mkrawiec261/RemoteCarSTM32/docs/Raport.pdf

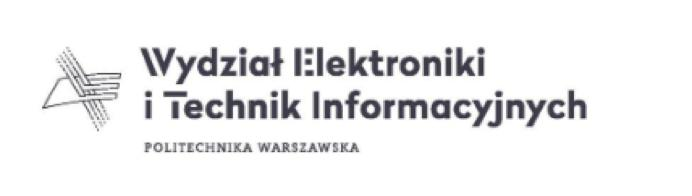
[picture p1: figure]

## 28 stycznia 2025

# Sprawozdanie PMiK

## Zdalnie sterowany samochodzik

Marcin Krawiec 325027
Tymoteusz Krasnowski 325026

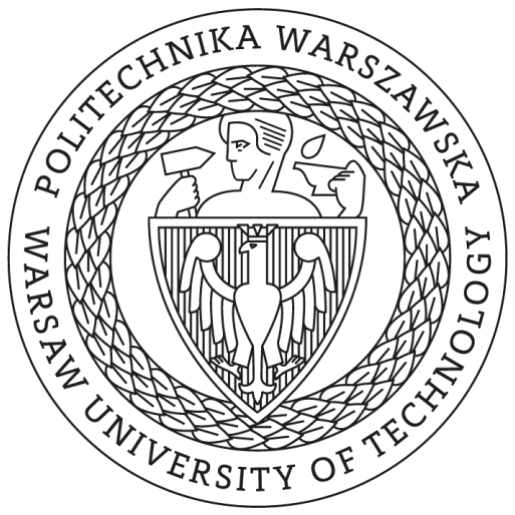
[picture p2: figure]

## Spis treści

## 1.Wstęp

## 1.1. Temat projektu

Tematem projektu jest zbudowanie od podstaw zdalnie sterowanego samochodu z napędem na cztery koła, z wykorzystaniem mikrokontrolera STM32 Nucleo. Sterowanie pojazdem będzie odbywać się bezprzewodowo, za pomocą joysticka komunikującego się z pojazdem przez moduły Wi-Fi oparte na ESP8266. Pojazd będzie zasilany napięciem ok. 6 V z połączonych ze sobą szeregowo baterii. Napęd składa się z 4 silników DC, sterowanych parami z drivera PWM. Dodatkowo, pojazd będzie posiadał czujnik odległości, który będzie ostrzegał użytkownika przed zbyt małą odległością od przeszkody za pomocą zapalenia czerwonej diody LED.

## 1.2. Wykaz realizowanych funkcji

1. Zastosowanie mikrokontrolerów STM32 Nucleo F303RE:
- Wykorzystanie dwóch STM32 jako jednostek centralnych sterujących pracą silników, odczytem danych z joysticka, komunikacją przez Wi-Fi oraz dodatkowymi czujnikami i peryferiami
2. Sterowanie napędem pojazdu:
- Regulacja pracy silników, za pomocą zewnętrznego drivera DRV8835,
- Regulacja prędkości za pomocą sygnału PWM generowanego przez mikrokontroler STM32
- Wybór kierunku obrotu silników za pomocą odpowiedniego stanu logicznego 2 portów GPIO
3. Sterowanie pojazdem za pomocą joysticka:
- Odczyt wychylenia gałki joysticka za pomocą napięć generowanych z dwóch potencjometrów oraz przetworzenie ich na wartość cyfrową za pomocą przetwornika ADC
- Komunikacja bezprzewodowa przez Wi-Fi
4. Obsługa czujnika odległości:
- Czujnik odległości odczytuje dystans od przeszkody i generuje przerwanie w momencie, gdy odległość jest mniejsza niż 30 cm. W obsłudze przerwania mikrokontroler zaświeca czerwoną diodę LED

## 1.3. Ogólny opis algorytmu

1. Inicjalizacja:
a. Konfigurowanie wszystkich wymaganych komponentów i urządzeń w tym pinów dla drivera silnika, modułów ESP8266, czujnika odległości i diod LED
b. Inicjalizacja liczników generujących sygnał PWM
c. Inicjalizacja modułów komunikacyjnych Wi-Fi do odbioru danych z joysticka
2. Obiór sygnałów z joysticka:
a. Odbiór informacji o wartości wychylenia joysticka w kierunku x i y
b. Przetworzenie danych przez ADC na wartości cyfrowe
3. Przekazywanie sygnałów poprzez Wi-Fi
a. Przesyłanie informacji o pozycji joysticka w osi x i y poprzez interfejs komunikacyjny UART do modułu ESP8266
b. Przesłanie danych między modułami ESP8266 i przekazanie ich do drugiego mikrokontrolera STM32 za pomocą UART
4. Sterowanie pracą silników:
a. STM32 odczytuje nadesłane dane i za pomocą algorytmu generuje 2 sygnały PWM o odpowiednim wypełnieniu, sterujące pracą silników. W tym momencie również wysterowuje linie GPIO w odpowiedni stan logiczny
5. Monitorowanie odległości od przeszkód:
a. Odczyt danych z czujnika odległości w pętli z wykorzystaniem timera
b. Jeżeli odległość jest mniejsza niż progowa, zapala się dioda LED ostrzegająca o możliwej kolizji
6. Aktualizacja stanu pojazdu:
a. System odbiera dane z joysticka i na bieżąco dostosowuje sygnał PWM do sterowania kierunkiem i prędkością

## 1.4. Wykaz użytych elementów

1. Zestaw ewaluacyjny STM32 Nucleo F303RE - 2x
2. Zestaw ewaluacyjny ESP32-WROOM-32
3. Moduł Wi-Fi ESP8266
4. Silnik szczotkowy DC FC-130SA - 4x
5. Driver DRV-8835 - 2x
6. Powerbank Xiaomi Redmi 10000 mAh
7. Baterie AAA - 6x
8. Koszyk na baterie AAA - 2x

## 2.Prace projektowe

## 2.1. Schemat blokowy

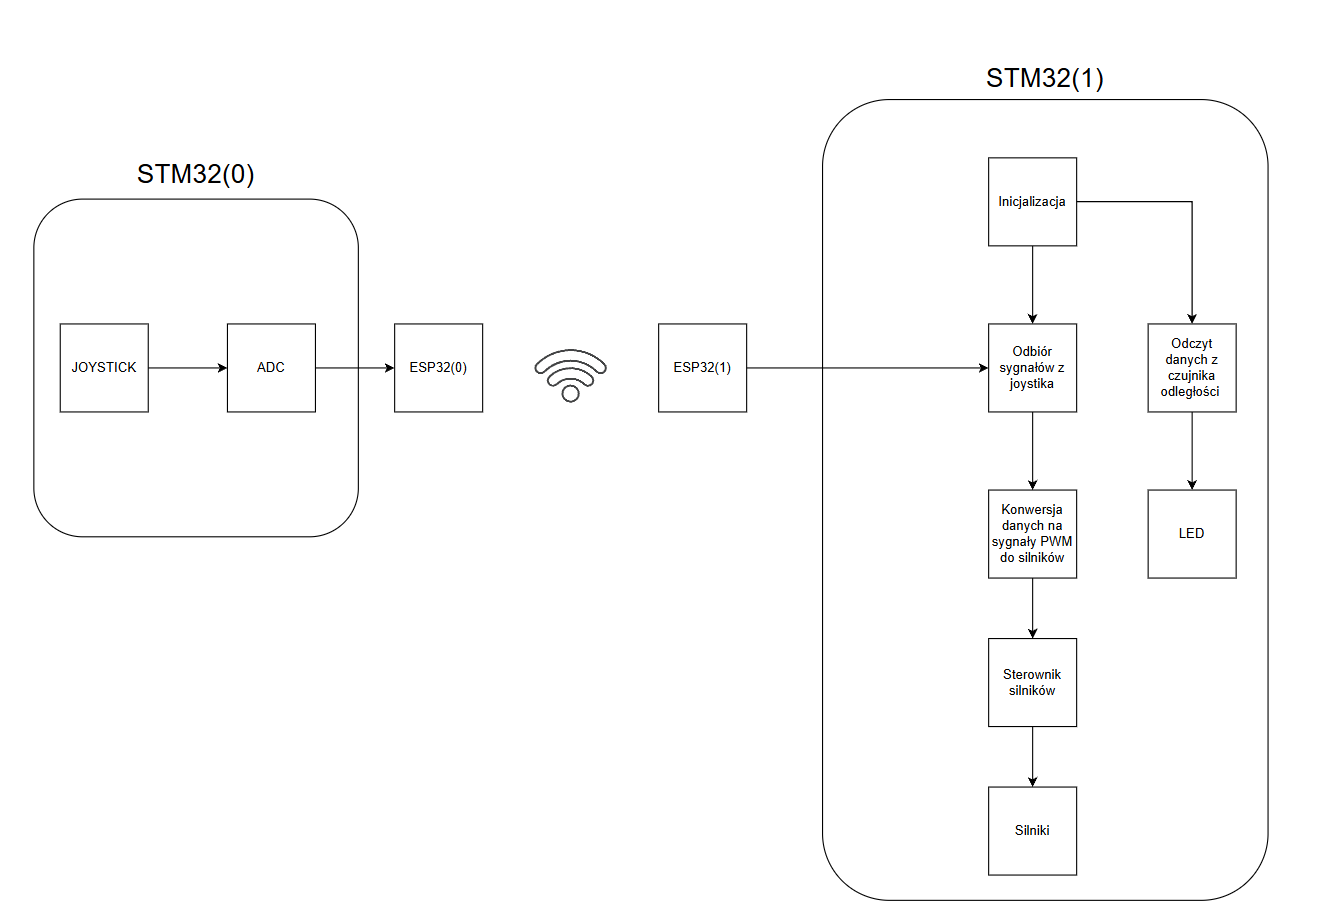
[picture p3: figure]

Rys 1. Schemat blokowy przedstawiający działanie samochodu i kontrolera

## 2.2. Schemat elektryczny

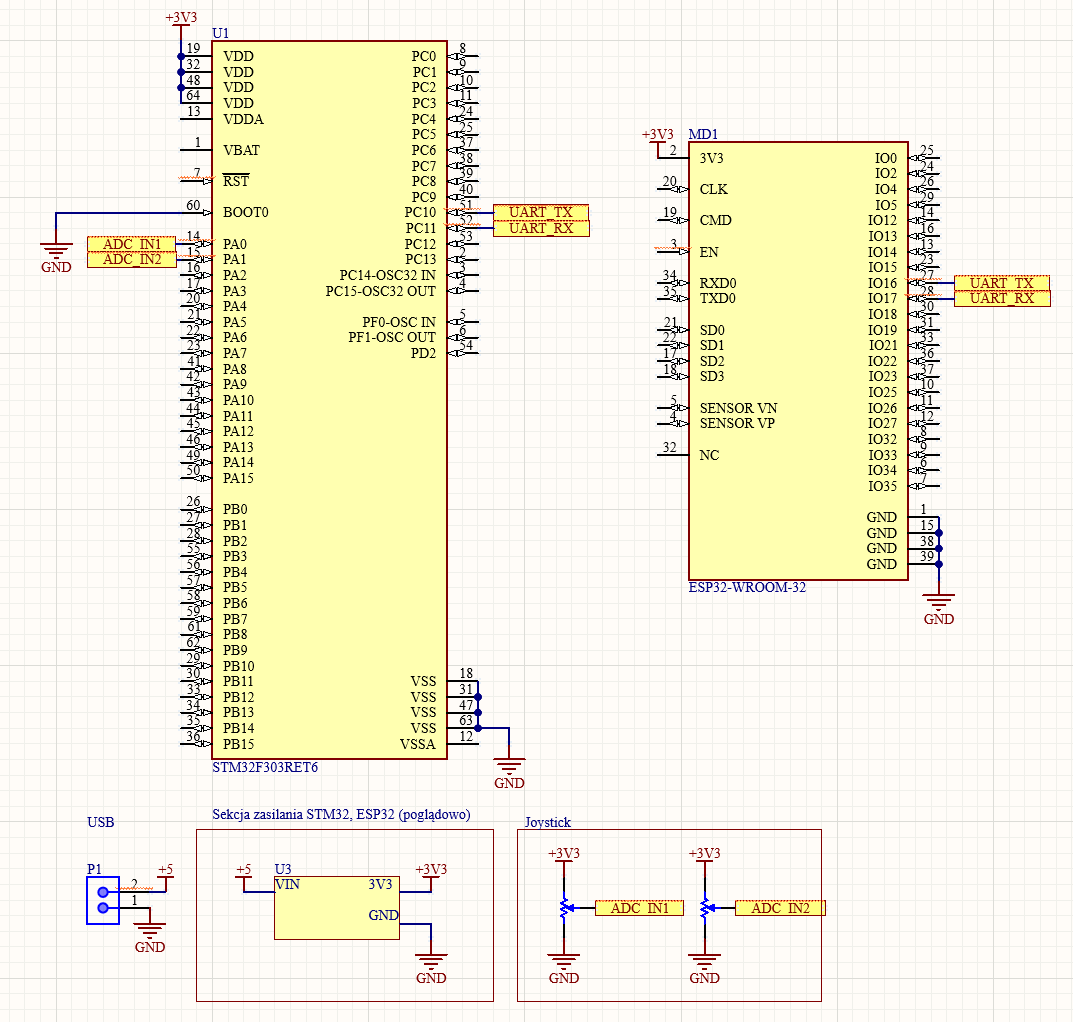
[picture p4: figure]

Rys 2. Schemat elektryczny kontrolera
Z racji na pusty (bez wyprowadzeń) prostokąt w Altium Designer zestawów ewaluacyjnych, na schemacie umieszczone są MCU. Pominięto w nich połączenia takie jak: debugger, diody, przyciski, kwarce itd. Natomiast dla przejrzystości zasilania układu, gdyż nie odbywa się przez port USB debuggera, widoczny jest blok sekcji zasilania (poglądowy).
Zasilanie kontrolera odbywa się przez USB-C z powerbanka. W Nucleo F303RE za zasilanie MCU odpowiada zworka w wyprowadzeniu J5, która wpinana jest na 2 sposoby: zasilanie z USB przez debugger oraz zewnętrznie. Dla naszych potrzeb zasilamy zewnętrznie. ESP32 nie posiada zworek, zasilanie odbywa się bezpośrednio wpinając się do pinu stabilizatora.

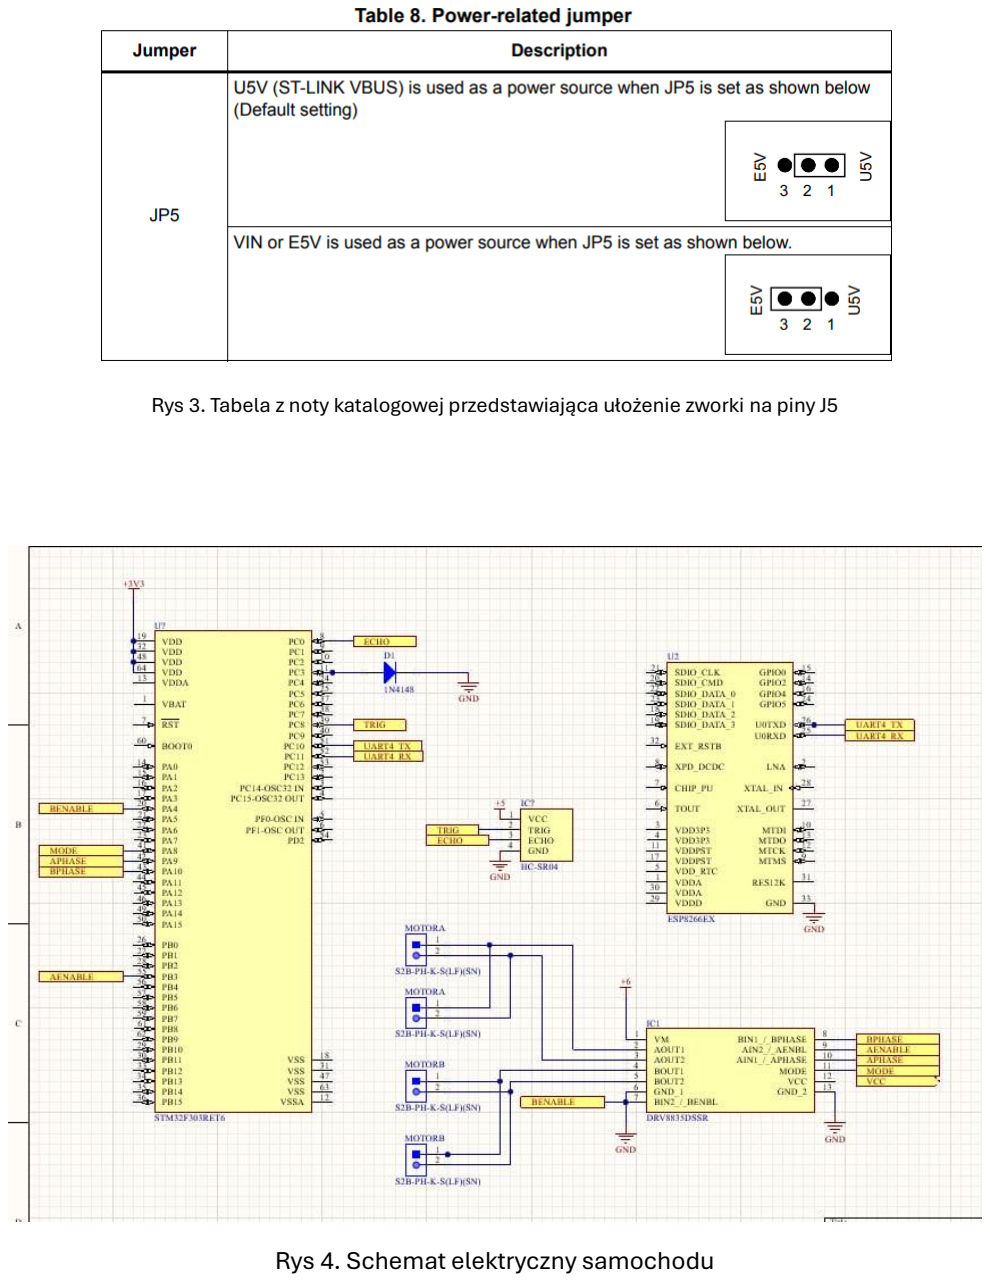
[picture p5: page 7]

Rys 3. Tabela z noty katalogowej przedstawiająca ułożenie zworki na piny J5

Rys 4. Schemat elektryczny samochodu

## 2.3. Komunikacja

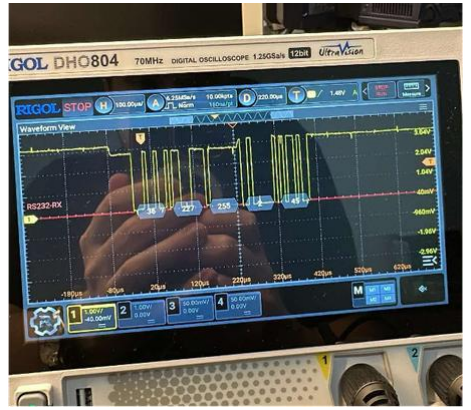
[picture p6: figure]

Rys 5. Podgląd komunikacji na oscyloskopie. Komunikacja odbywa się za pomocą interfejsu UART i protokołu ESP-NOW między ESP32. STM32 po stronie kontrolera wysyła 5 bajtów: ramka i 4 wartości z ADC, odpowiednio: starszy i młodszy bajt wychylenia X joysticka oraz starszy i młodszy bajt wychylenia Y joysticka.

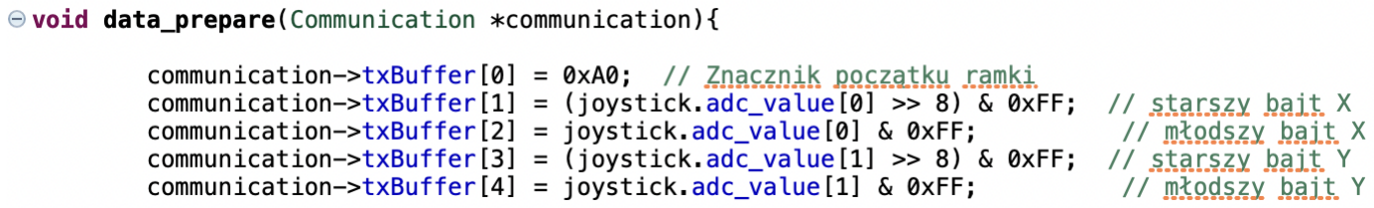
[picture p7: figure]

Rys 6. Bufor danych do wysłania, z ramką i rozdzieleniem wartości 16 bitowych na dwie 8-bitowe. Następnie dane są wysyłane do ESP32 z prędkością 115200 b/s przez DMA. Tam następuje ich odbiór i wysyłka za pomocą protokołu ESP-NOW, o ile zostanie znaleziony adres MAC odbiorcy.

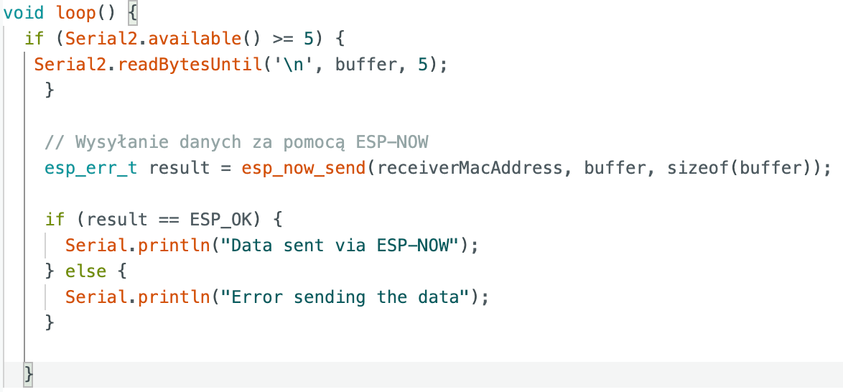
[picture p8: figure]

Rys 7. Pętla główna ESP32, w której dane są odczytywane z UART (Serial2) i wysyłane (esp_now_send).
Protokół ESP-NOW odbiera dane tylko w przerwaniu, zatem za każdym razem, gdy przyjdą nowe dane, wywołuje się przerwanie, w którym dane są kopiowane i wysyłane za pomocą UART do drugiej STM32.

Rys 8. Callback do odbioru danych, pętla while jest pusta.
Warto tutaj zaznaczyć, że domyślnie ESP32 jak i moduł ESP8266 sygnalizują status komunikacji niebieską diodą, dzięki czemu, gdy wystąpi jakiś problem można od razu wiedzieć, czy komunikacja przebiega prawidłowo – ułatwiony debugging. Następnie, dane muszą zostać z powrotem przekonwertowane na swoje 16-bitowe wartości. Służy do tego funkcja convertwifitada.

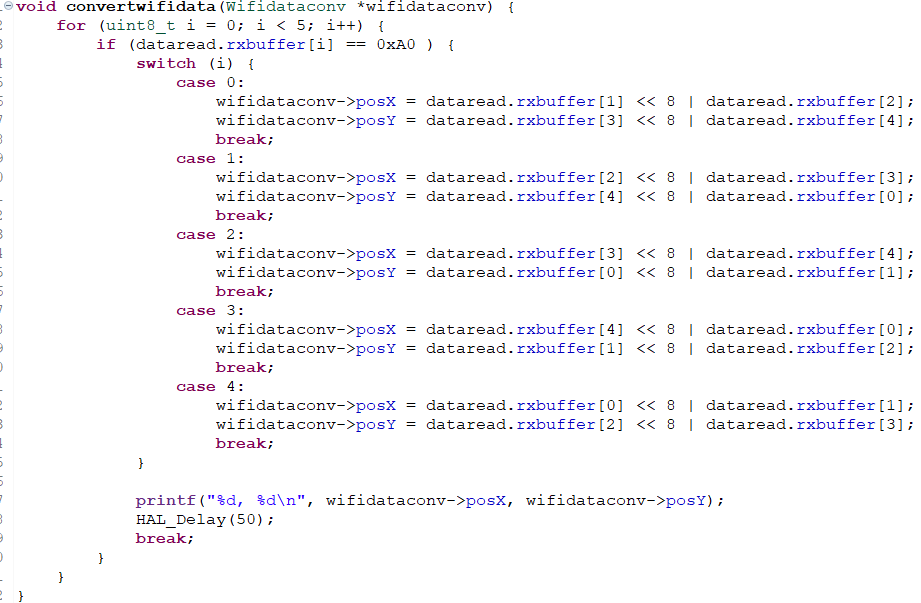
[picture p9: figure]

Rys 9. Funkcja convertwifidata
Ta funkcja nie tylko konwertuje 2 8-bitowe wartości na jedną 16-bitową, ale też wyszukuje ramki, czyli początku transmisji. Po odbiorze danych przez ESP8266 okazało się, że ramki nie przychodzą po kolei – są przesunięte w czasie. Musiał powstać mechanizm, który zapewni poprawny odczyt danych.
Jednak to nie koniec. Wartości z ADC potrafią być zaszumione, za sprawą beznadziejnej jakości joysticka z zestawu ewaluacyjnego arduino (klon, chińczyk), a podczas transmisji po Wi-Fi danych również może dość do uszkodzenia jej zawartości. W związku z tym, po odbiorze danych i konwersji ich do docelowych wartości, powstał filtr medianowy. Dzięki temu prostemu rozwiązaniu problem zniknął, a sama transmisja i jej dekodowanie pozostało niezmienione (mam tu na myśli bardziej zaawansowany mechanizm, na przykład z sumą kontrolną).

## 2.4. ADC

Joystick to nic innego jak dwa potencjometry, których rezystancję reguluje się odchyleniem gałki analogowej. Zatem obsługa joysticka wymaga użycia przetwornika analogowo-cyfrowego. Próbkuje on wartości z dwóch kanałów – X i Y gałki analogowej, o rozdzielczości 12 bitów i wysyła bezpośrednio do DMA.
ADC odczytuje wartości odchylenia joysticka z prędkością 61.5 cykli.

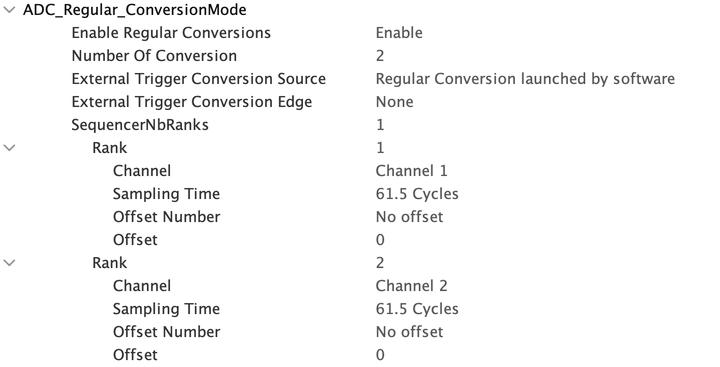
[picture p10: figure]

Rys 10. Fragment konfiguracji ADC z IOC.
2.4.1 Obsługa joysticka – plik konfiguracyjny i wykonawczy:

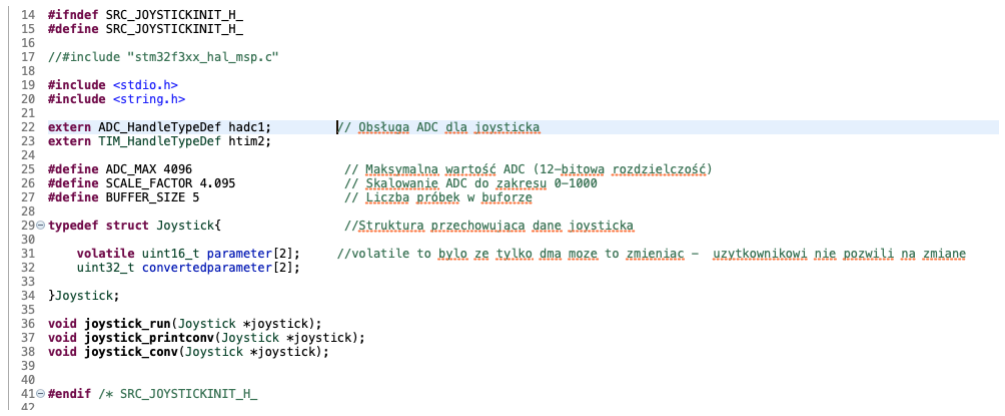
[picture p11: figure]

Rys 11. Plik konfiguracyjny joystickinit.h Plik joystickinit.h jest stworzoną przez nas biblioteką obsługi joysticka. Znajdują się w niej definicje przetwornika, odpowiednie stałe pozwalające na konwersje danych przekazywanych z ADC na takie bardziej przystępne dla naszych wymagań. Następnie plik zawiera strukturę danych, ze zmiennymi w postaci tablicy, do której przypisywane są aktualne wartości wychylenia joysticka. Plik zakończony jest deklaracjami funkcji wykorzystywanych w pliku implementacyjnym.

Rys 12. Plik implementacyjny joystickstart.c – funkcja obsługi ADC z DMA Funkcja joystick_run zawiera fragment inicjalizacji ADC oraz jego kalibracji, wraz z ze startem DMA. Pozwala na rozpoczęcie odczytywania danych z joysticka i zapisywanie ich w tablicy parameter[]. Następnie te dane zostają wysłane do drugiego STM32 zgodnie z procedurą opisaną powyżej.

## 2.5. Odczyt danych i filtracja:

Wysyłanie danych poprzez Wi-Fi ma tą niewygodną cechę, że wartości są dość podatne na szumy występujące w przestrzeni. W naszym projekcie sam fakt, że moduł ESP odbierający dane był bardzo blisko silników prądu stałego, które mogą powodować zakłamania odbieranych wartości. Problem występuje co kilka, kilkanaście próbek dlatego podjęliśmy działania mające na celu eliminację tego problemu.

Pierwszym z nich było zastosowanie filtru medianowego:

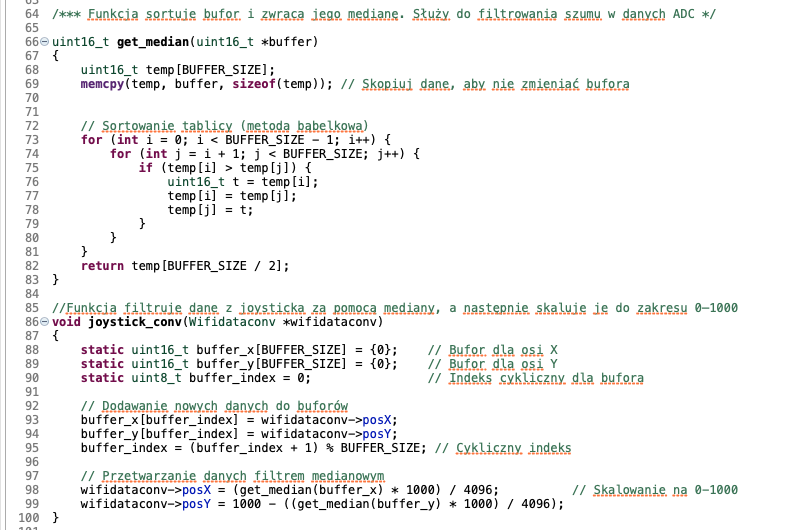
[picture p12: figure]

Rys 13. Plik wifidataconvert.c – funkcja filtrująca dane i skalująca do odpowiednich wartości

Pierwsza funkcja, get_median, jest odpowiedzialna za filtrowanie danych. Implementuje metodę mediany, polegającą na posortowaniu kopii tablicy danych i wybraniu wartości środkowej. Dane są kopiowane do tymczasowej tablicy temp, aby nie zmieniać oryginalnych wartości. Następnie funkcja stosuje algorytm sortowania bąbelkowego, który porównuje i zamienia miejscami elementy, aż cała tablica zostanie uporządkowana. Po zakończeniu zwracana jest mediana wartości. Mediana jest używana, ponieważ skutecznie eliminuje wpływ pojedynczych, znacząco odchylonych wartości (szumów) na dane wejściowe.

Druga funkcja, joystick_conv, wykorzystuje funkcję get_median do przetwarzania danych z joysticka. Dane te są reprezentowane przez współrzędne osi X i Y, które są
odczytywane z obiektu Wifidataconv. Funkcja przechowuje ostatnie wartości z joysticka w dwóch oddzielnych buforach, jednym dla osi X i jednym dla osi Y. Bufory te mają ustaloną wielkość (zdefiniowaną przez BUFFER_SIZE), a nowe wartości są dodawane w sposób cykliczny, nadpisując najstarsze dane.
Dla każdej nowej wartości dane w buforze są przetwarzane za pomocą
funkcji get_median, co pozwala na odfiltrowanie szumów. Po zastosowaniu mediany wartości są skalowane do zakresu 0–1000.
Drugą metodą, którą szerzej opiszę w pętli głównej jest zastosowanie ogranicznika wartości. W momencie, gdy po skalowaniu wartości, wychylenia joysticka są większe niż 1000 (czyli większe niż maksymalne wypełnienie PWM) to wykorzystywana jest funkcja ograniczająca ten zakres do wartości maksymalnej – 1000.
Wszystkie stałe opisane są w bibliotece wifidataconvert.h:

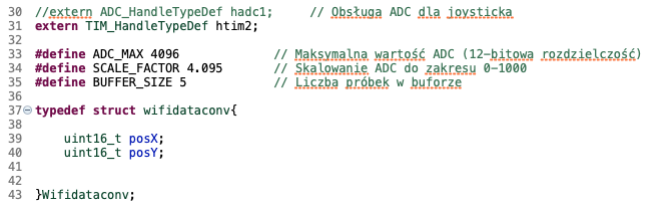
[picture p13: figure]

Rys. 14 Struktury danych do obsługi wartości z joysticka

## 2.6. Sterowanie silnikami DC 5V

2.6.1 Sterownik DRV8835:

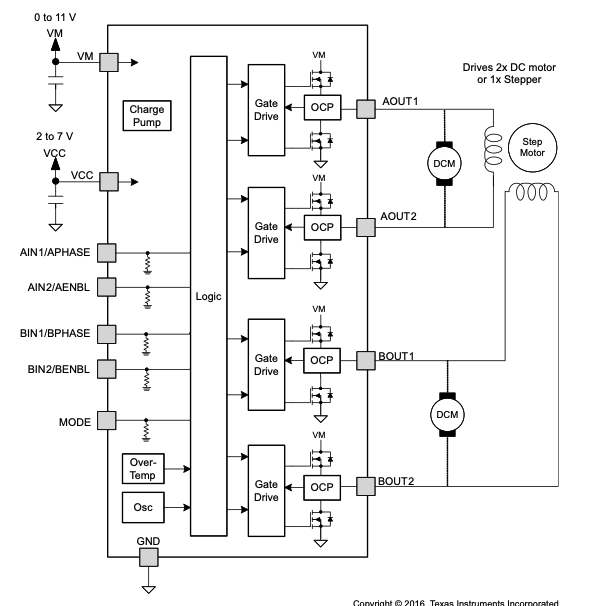
[picture p14: figure]

Rys. 15 Schemat blokowy drivera

DRV8835 to zintegrowany układ sterownika silnika przeznaczony do sterowania silnikami szczotkowymi. Urządzenie integruje dwa mostki H, co umożliwia sterowanie dwoma silnikami DC lub jednym silnikiem krokowym. Blok wyjściowy każdego mostka H składa się z tranzystorów mocy MOSFET typu N. Wewnętrzna pompa ładunkowa generuje napięcia sterujące bramkami tranzystorów. Funkcje ochronne obejmują ochronę przed przeciążeniem prądowym, zwarciem, blokadę podnapięciową oraz ochronę przed przegrzaniem.

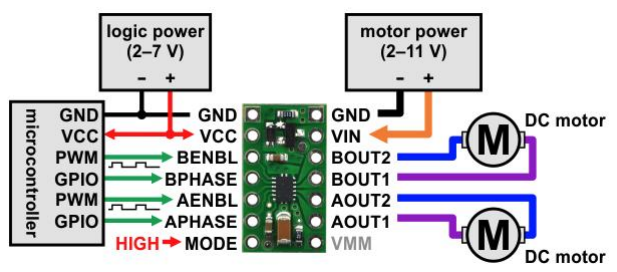
[picture p15: figure]

Rys. 12 Schemat połączeń drivera z silnikami i STM32
Sterownik ma dwa tryby pracy, które możemy wybrać za pomocą stanu niskiego lub wysokiego na wejściu MODE:
- Tryb PHASE/ENABLE to prostszy tryb sterowania – do uruchomienia silnika potrzebujemy jednego sygnału PWM oraz jednego sygnału cyfrowego GPIO. W trybie tym możemy sterować zarówno kierunkiem, jak i prędkością obrotu silnika oraz wywołać hamowanie. W naszym programie wykorzystaliśmy tryb PHASE/ENABLE
- Tryb IN/IN pozwala na bardziej zaawansowane sterowanie silnikiem. Do uruchomienia tego trybu wymagane są dwa sygnały PWM. Poza sterowaniem kierunkiem i prędkością oraz hamowaniem, mamy też możliwość wyłączenia wyjść sterownika (bieg jałowy).

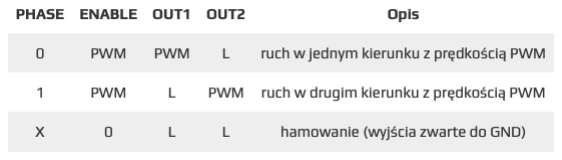
[picture p16: figure]

Rys. 13 Opis funkcjonalności drivera dla PWM

Częstotliwość sygnałów PWM z obydwu kanałów timera została ustawiona na 10 Hz, co pozwala na pracę silników z pełną mocą. Zgodnie ze wzorem:

PWM_Freq = Timer_Freq / (Prescaler * Counter Period)

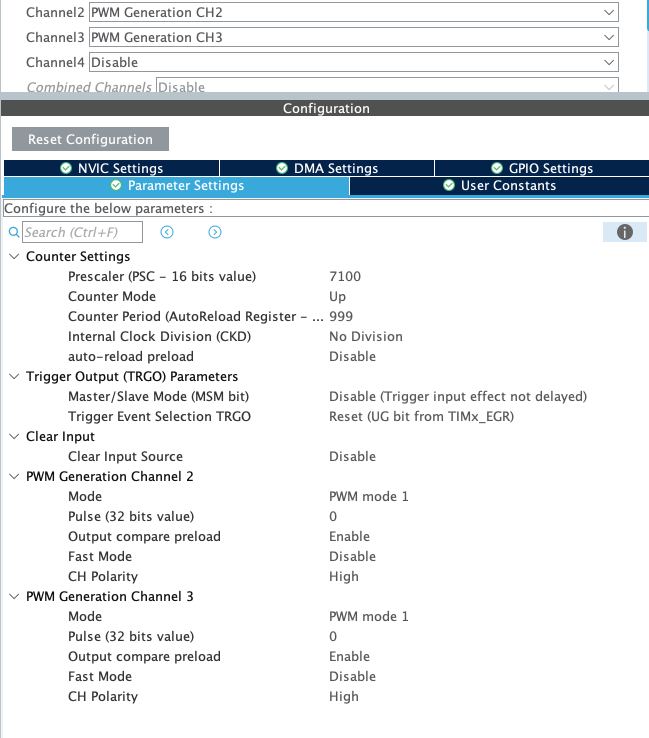
[picture p17: figure]

Rys. 14 Konfiguracja timera dla sygnału PWM

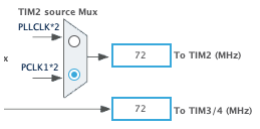
[picture p18: figure]

Rys. 15 Częstotliwość zegara dla timera 2

2.6.2 Funkcje sterujące pracą drivera:

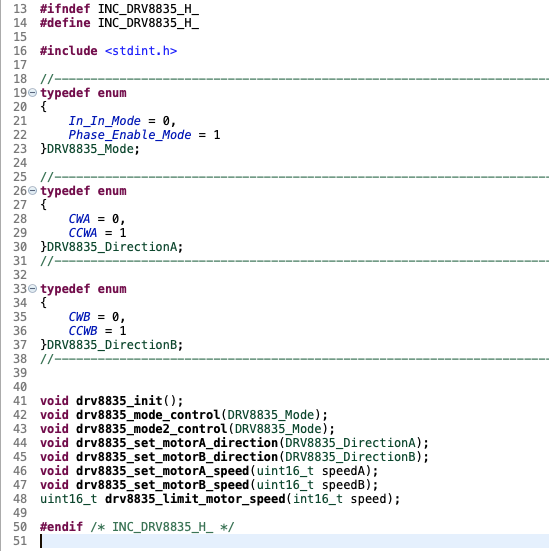
[picture p19: figure]

Rys. 16: drv8835.h interfejs do sterowania mostkiem H DRV8835 Plik drv8835.h definiuje interfejs do sterowania mostkiem H DRV8835. Znajdują się w nim:
1. Typy wyliczeniowe:
- DRV8835_Mode: Tryby pracy sterownika:
- In_In_Mode – bezpośrednie sterowanie sygnałami kierunkowymi.
- Phase_Enable_Mode – sterowanie za pomocą sygnału fazowego i PWM.
- DRV8835_DirectionA i DRV8835_DirectionB: Kierunki obrotów dla silników A i B (zgodny lub przeciwny do ruchu wskazówek zegara).
2. Implementacje funkcji

W pliku drv8835.c znajdują się funkcje obsługujące sterownik:

Rys.17 Funkcja wyboru trybu pracy

Funkcja wyboru trybu pracy ustawia port GPIO PA8 (nazwa MODE) w odpowiedni stan w zależności od trybu pracy. W naszym przypadku jest to stan wysoki (tryb
PHASE/ENABLE)

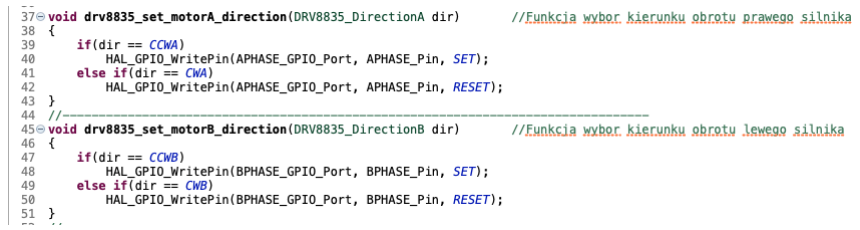
[picture p20: figure]

Rys.18 Funkcja wyboru kierunku obrotów Funkcja ta wystawia na porty GPIO PA9 i PA10 odpowiednie stany logiczne umożliwiające wybór kierunku obrotów silnika. Są 2 możliwości CW – „clockwise” – zgodnie z ruchem wskazówek zegara i CCW – „counter clockwise” – przeciwnie do ruchu wskazówek zegara.

Rys.19 Funkcja przypisujące prędkość

Te dwie funkcje przypisują bezpośrednio wartość do rejestru CCR2 licznika 2 i CCR3 licznika 3. W ten sposób odbywa się modulowanie wartości wypełnienia sygnału PWM z odpowiednich liczników. W związku z tym, że wartość speedA i speedB jesy bezpośrednio przypisywana do rejestru, a maksymalne wypełnieni współczynnika PWM to 1000 to musi jeszcze być stworzona funkcja ograniczająca maksymalny zakres zmiennuch speed.

Rys.20 Funkcja ograniczająca wartości zmiennych speed Funkcja drv8835_limit_motor_speed zapewnia, że do rejestrów CCR2 TIM2 I CCR3 TIM3 nie zostanie przypisana wartość spoza zakresu 0-1000.

## 2.7 Czujnik odległości HC SR-04

2.7.1 Opis czujnika
HC-SR04 to ultradźwiękowy czujnik odległości, czyli czujnik, który do pomiaru wykorzystuje falę dźwiękową o częstotliwości niesłyszalnej dla człowieka. Taką częstotliwość wykorzystują często zwierzęta np. pies, delfin czy nietoperz. Ultradźwięki dzięki małej długości fali wykorzystywane są przez człowieka m.in. w sonarach okrętów podwodnych (do detekcji obiektów) oraz medycynie.
Czujnik HC-SR04 wykorzystuje falę dźwiękową o częstotliwości 40 kHz. Zbudowany jest z nadajnika i odbiornika oraz zestawu układów elektronicznych, które wstępnie przetwarzają sygnał generowany przez nadajnik oraz przychodzący do odbiornika w taki sposób, aby wyprowadzić nam sygnał możliwie łatwy do odczytu. Czujnik standardowo ma wyprowadzone cztery piny: VCC(zasilanie), GND (masa), TRIG (wejście wyzwalające pomiar) oraz ECHO (wyjście zwracające wartość pomiaru).

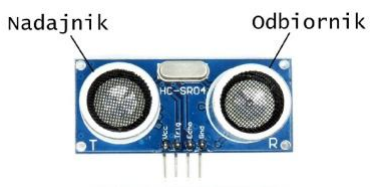
[picture p21: figure]

Rys. 21 Czujnik HC-SR04

Interfejs czujnika (wejście TRIG i wyjście ECHO) bazuje na sygnałach czasowych. Aby wywołać pomiar, należy podać na pin TRIG stan wysoki o czasie trwania minimum 10 us. Sygnał ten zamieniany jest na osiem impulsów o częstotliwości 40 kHz i generowany przez sondę nadawczą. Jeżeli fala dźwiękowa napotka przeszkodę na swojej drodze, odbija się od niej i wraca do odbiornika. Czujnik na wyjściu ECHO generuje impuls o szerokości proporcjonalnej do zmierzonej odległości.

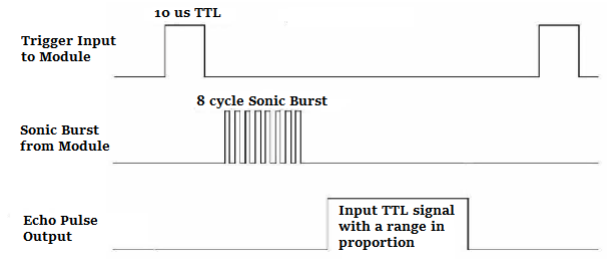
[picture p22: figure]

Rys. 22 Praca czujnika

Pomiar czasu trwania impulsu na wyjściu ECHO pozwala nam na odczytanie, w jakiej odległości od czujnika znajduje się przeszkoda. Zamiana czasu trwania impulsu na odległość podaną w centymetrach sprowadza się do prostych obliczeń matematycznych. Czas impulsu jest bowiem ściśle związany z czasem wędrowania fali dźwiękowej do przeszkody i z powrotem. Wiedząc, że fala dźwiękowa porusza się z prędkością 340 m/s, możemy obliczyć odległość, jaką przebyła. Ponieważ interesuje nas odległość do przedmiotu, musimy podzielić drogę przebytą przez falę dźwiękową przez 2.

odległość_m = (340 m/s * czas_impulsu_s) / 2

Czujnik może pracować w 3 trybach, jednak my wykorzystaliśmy tryb PWM Input. Jest on swego rodzaju odmianą tryb Input Capture – wykorzystuje dwa sygnały Input Capture zmapowane na ten sam pin. Każdy z sygnałów jest aktywny na inne zbocze – pierwszy na zbocze narastające, a drugi na opadające. W momencie wywołania pierwszego zbocza licznik jest resetowany. Gdy nastąpi zbocze opadające pobierana jest informacja o liczniku i zapisywana w rejestrze CCR2 (kanał 2). W momencie wystąpienia kolejnego zbocza narastającego, w rejestrze CCR1 zapisywana jest informacja o okresie sygnału.

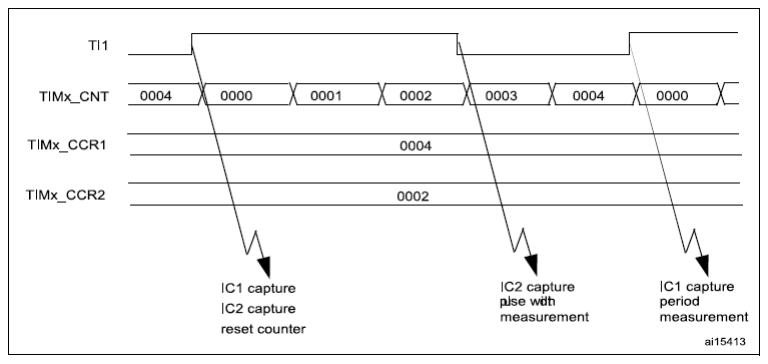
[picture p23: figure]

Rys. 23 Tryb PWM Input
2.7.2 Funkcje sterujące czujnikiem

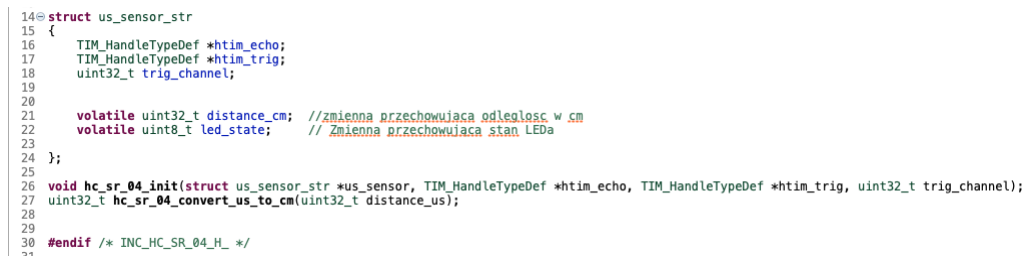
[picture p24: figure]

Rys. 24 Plik konfiguracyjny hc_sr_04.h W pliku hc_sr_04.h stworzymy strukturę, która będzie przechowywała informację o używanych timerach oraz zmierzoną odległość. Dodajemy również deklaracje funkcji i typdef-a.

Rys. 25 Funkcja inicjalizująca pracę czujnika

Funkcja hc_sr_04_init Służy do inicjalizacji czujnika HC-SR04. Przyjmuje wskaźnik na strukturę us_sensor_str reprezentującą stan czujnika oraz wskaźniki na uchwyty timerów STM32 używanych do obsługi trybów Echo i Trigger.
1. Przypisanie timerów:
- htim_echo: Timer używany do pomiaru czasu trwania echa (Input Capture).
- htim_trig: Timer generujący sygnał Trigger (PWM).
- trig_channel: Kanał timera przypisany do wyjścia Trigger.
2. Uruchomienie timerów:
- Aktywuje tryb Input Capture dla pomiaru czasu trwania sygnału Echo. Działa na kanałach TIM_CHANNEL_1 i TIM_CHANNEL_2.
- Rozpoczyna generowanie sygnału PWM na kanale odpowiedzialnym za Trigger.

Rys. 25 Funkcja konwersji czasu na odległość Służy do konwersji zmierzonego czasu (w mikrosekundach) na odległość (w centymetrach). Stała konwersji HC_SR04_US_TO_CM_CONVERTER wynosi 58 i odpowiada przelicznikowi: 1 cm = 58 mikrosekund.
Czujnik odczytuje odległość w pętli. Jeżeli jednak zmierzona odległość będzie mniejsza niż 30 cm to czujink zgłosi przerwanie, a w jego obsłudze mikrokontroler wystawia stan wysoki na pin PC3 (Led_Warning), do którego podłączona jest zewnętrzna dioda LED.

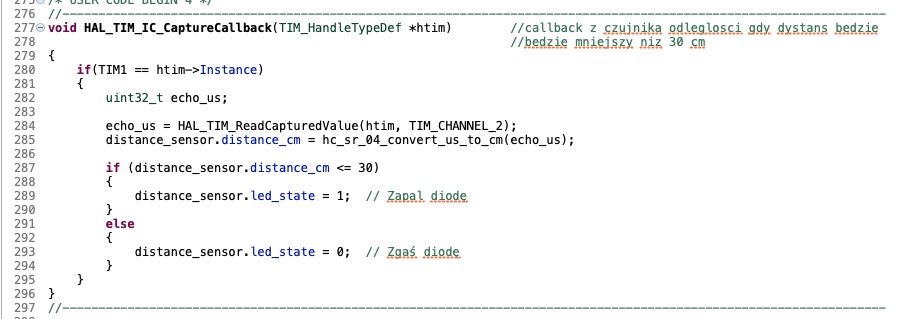
[picture p25: figure]

Rys. 26 Callback od przerwania zgłoszonego przez czujnik

## 2.8 Pętla główna:

W pętli głównej STM32 wykorzystywanej do odczytywania wartości z joysticka jest jedynie zaimplementowana funkcja wysylania danych do ESP ponieważ sam odczyt danych z joysticka odbywa się przez DMA więc nie musimy już nic więcej inicjować

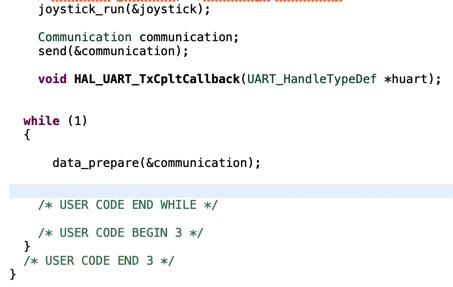
[picture p26: figure]

Rys. 27 Pętla główna STM32(0)
2.8.1 Struktura danych zmiennych w pętli main STM32(1):

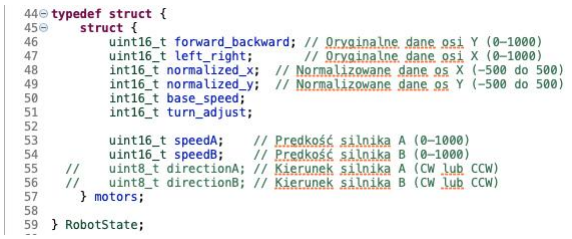
[picture p27: figure]

Rys. 27 Struktura danych zmiennych w pętli

2.8.2 Algorytm obliczania mocy silników w pętli głównej STM32(1):

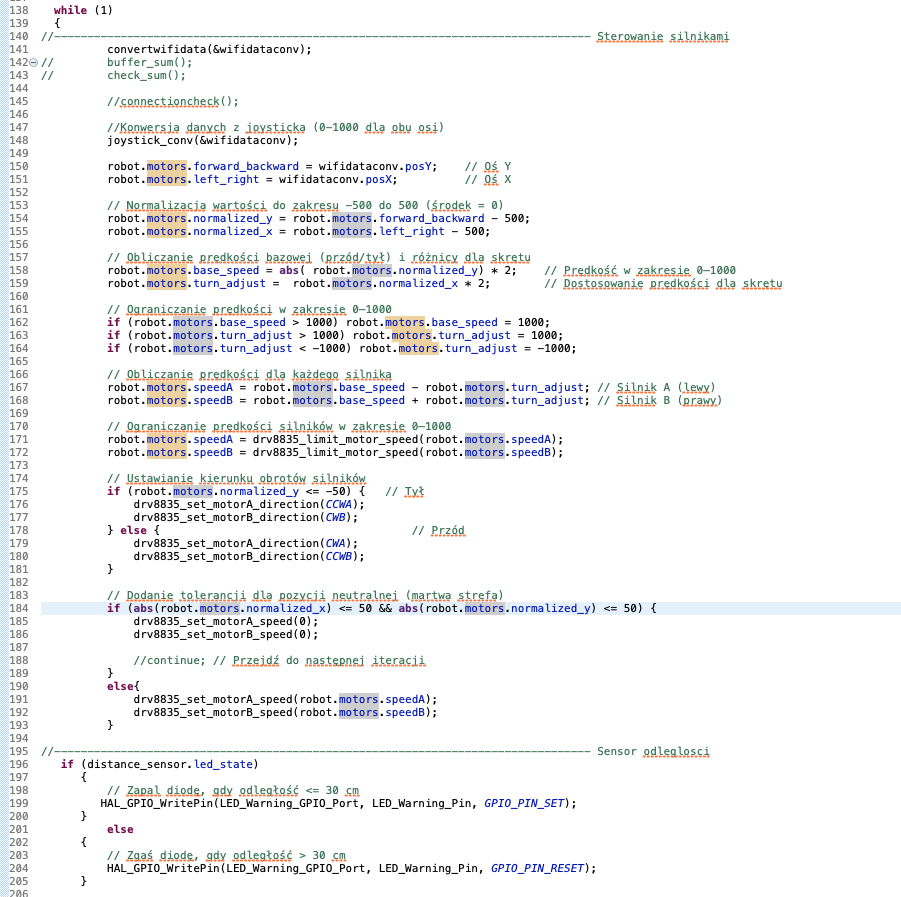
[picture p28: figure]

Rys. 28 Pętla główna
Opis algorytmu:
1. Pobranie danych wejściowych:
- Dane z joysticka (w zakresie 0–1000 dla osi X i Y) są przetwarzane przez funkcję joystick_conv, a następnie zapisane w strukturze wifidataconv.
- Dane z osi Y (posY) reprezentują ruch przód-tył.
- Dane z osi X (posX) reprezentują ruch lewo-prawo.
2. Normalizacja danych:

- Wartości z joysticka są przesuwane, aby środek zakresu znajdował się w punkcie 0:
- normalized_y = posY - 500 – określa ruch przód-tył (wartości dodatnie dla przodu, ujemne dla tyłu).
- normalized_x = posX - 500 – określa ruch lewo-prawo (wartości dodatnie dla skrętu w prawo, ujemne dla skrętu w lewo).
3. Obliczenie prędkości:
- base_speed: prędkość bazowa silników zależy od wartości na osi Y i jest skalowana do zakresu 0–1000.
- turn_adjust: korekta prędkości zależy od osi X i jest proporcjonalna do odchylenia joysticka od środka (lewo-prawo).
4. Ograniczenie wartości prędkości:
- Prędkość bazowa oraz korekta są ograniczane do zakresu 0–1000, aby zapobiec przekroczeniu maksymalnych wartości PWM.
5. Obliczenie prędkości dla każdego silnika:
- Prędkości dla lewego i prawego silnika są obliczane w oparciu o:
- speedA = base_speed - turn_adjust – prawy silnik zwalnia podczas skrętu w prawo.
- speedB = base_speed + turn_adjust – lewy silnik przyspiesza podczas skrętu w prawo.
- Prędkości są dodatkowo ograniczane przez
funkcję drv8835_limit_motor_speed.
6. Ustawienie kierunków obrotów:
- Kierunki obrotu silników są ustawiane na podstawie wartości normalized_y:
- Jeśli joystick wskazuje wartość poniżej -50, samochód porusza się do tyłu (CCWA dla lewego i CWB dla prawego silnika).
- W przeciwnym wypadku samochód porusza się do przodu (CWA dla lewego i CCWB dla prawego silnika).
7. Martwa strefa (neutralna):
- Jeśli joystick znajduje się w zakresie neutralnym (wartości X i Y bliskie środka, tj. ±50), silniki są zatrzymywane (speedA = speedB = 0).
8. Przypisanie prędkości do silników:

- Jeśli joystick wyjdzie poza martwą strefę, prędkości i kierunki są przypisywane do sterownika silników za pomocą
funkcji drv8835_set_motorA_speed i drv8835_set_motorB_speed.
9. Sprawdzanie stanu diody wartości z czujnika:
- Jeśli led.state ma wartość 1 to znaczy, że zgłoszono przerwanie, odległość mniejsza od 30cm mikrokontroler zapala diodę led.
2.8.3 Praca układu:

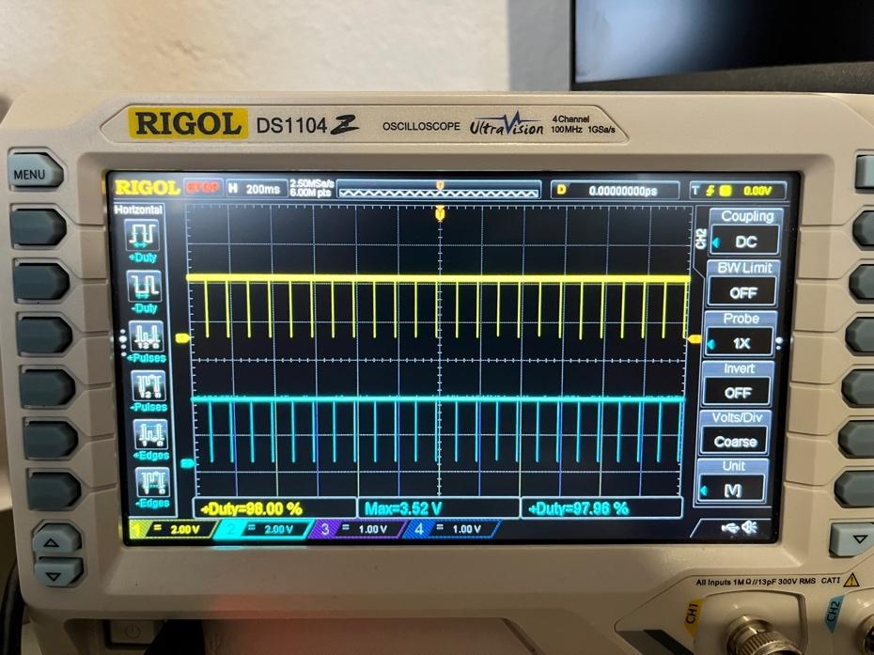
[picture p29: figure]

Rys. 29 Maksymalne wychylenie joysticka w przód – silniki pracują z maksymalną mocą (100% wypełnienia)

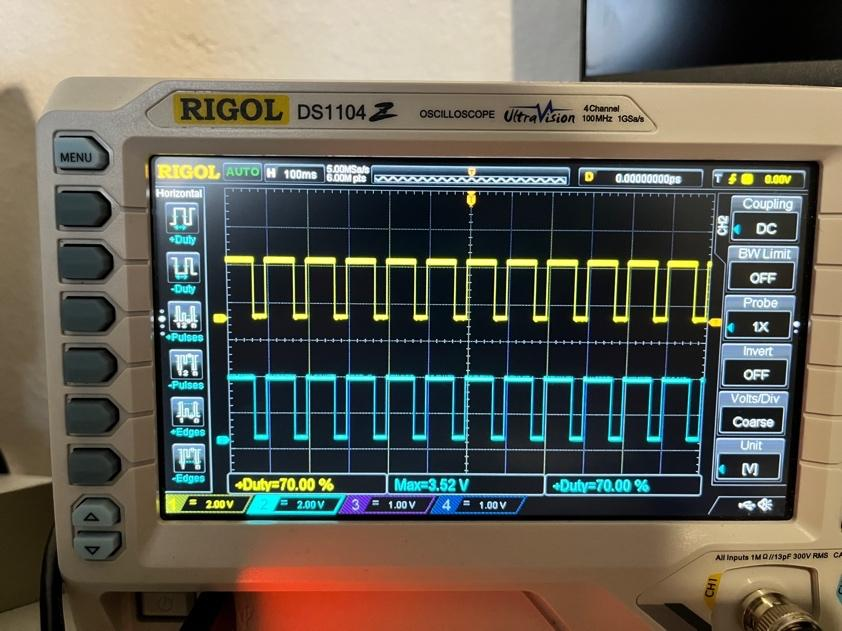
[picture p30: figure]

Rys. 30 Lekkie wychylenie joysticka w przód, powyżej strefy martwej

Obydwa silniki pracują z taką samą mocą, jednak wychylenie joysticka nie jest liniowe i bardzo szybko po wyjściu ze strefy martwej, pojazd nabiera prędkości

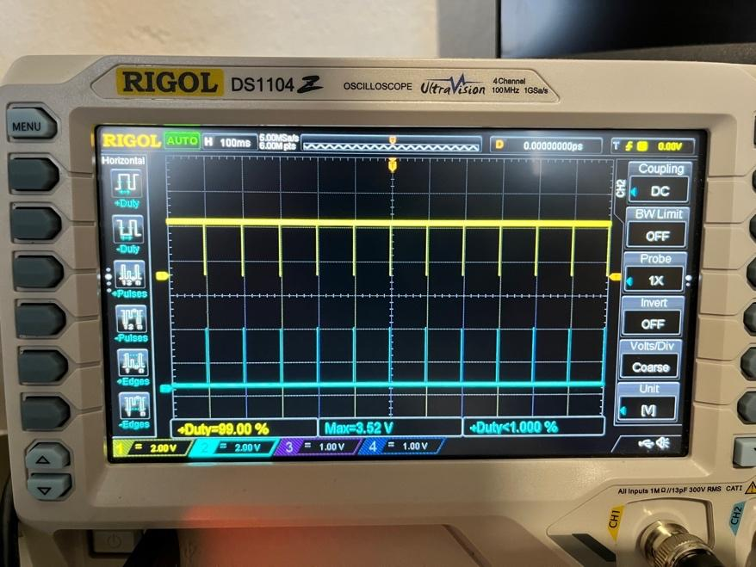
[picture p31: figure]

Rys. 31 Maksymalny skręt w prawy, silnik prawy nie pracuje, natomiast lewy pracuje z maksymalną mocą

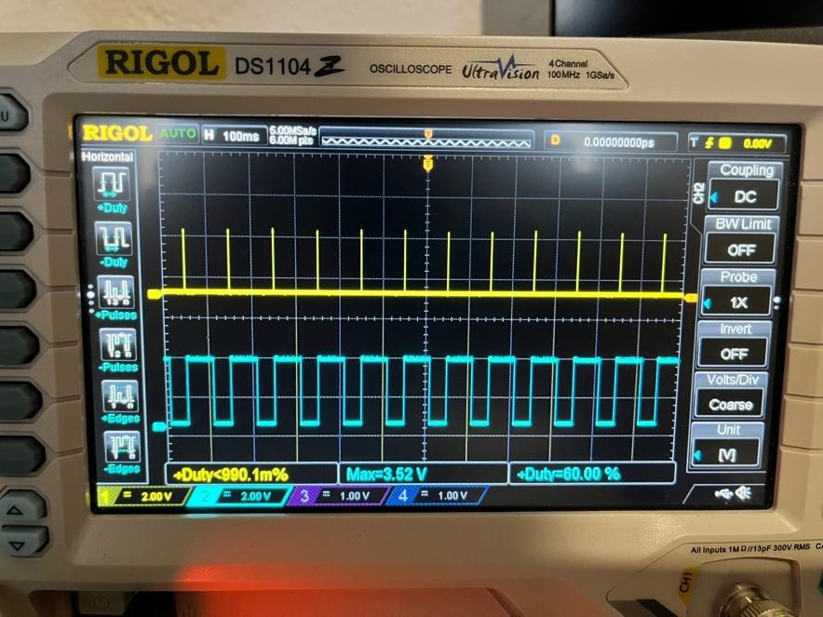
[picture p32: figure]

Rys. 32 Lekki skręt w lewo, silnik lewy nie pracuje a prawy pracuje z mocą proporcjonalną do wychylenia

## 3 Napotkane problemy i ich rozwiązania

## 3.1 Błędne odczyty ADC

Z racji na 12-bitową rozdzielczość przetwornika analogowo-cyfrowego, zakres wartości jakie może odczytać jest w zakresie 0-4096. Joystick w spoczynku jest w połowie rezystancji. Przy szybszym próbkowaniu wartości były bardzo podatne na rozrzut, jak i sam joystick pozostawia wiele do życzenia. Przy delikatnym ruszaniu można stwierdzić, że nie jest do końca liniowy – ma zakres, gdzie zmiany są marginalne. Wyjaśnieniem tego jest fakt, że pochodzi on z zestawu ewaluacyjnego dla klona Arduino, zakupionego na znanej chińskiej platformie internetowej. Natomiast błędne pomiary zostały wyeliminowane zwiększając czas odczytu danych.

## 3.2 Transmisja danych STM32 – ESP32

Początkowo transmisja miała odbywać się za pomocą SPI. Niestety, domyślnie ESP32 nie wspiera odbioru danych (bycia slavem) z tego interfejsu, więc koniecznie było użycie zewnętrznych bibliotek. Niestety nie działały. Zatem po długiej walce postanowiliśmy użyć do tego celu UART. Z tego poziomu już wszystko działało, ESP32 prawidłowo odczytywał dane.

## 3.3 Transmisja danych za pomocą WiFi

Zanim znalazłem protokół ESP-NOW dane otrzymywane przez ESP32 trafiały na serwer http. Mikrokontroler działał jako access point, z nazwą SSID i hasłem. Po przyłączeniu się do jego sieci można było wejść na stronę z poziomu przeglądarki, i odświeżając stronę dane się aktualizowały – był to serwer http asynchroniczny. Zostały do tego użyte biblioteki EPAAsyncWebServer z githuba.

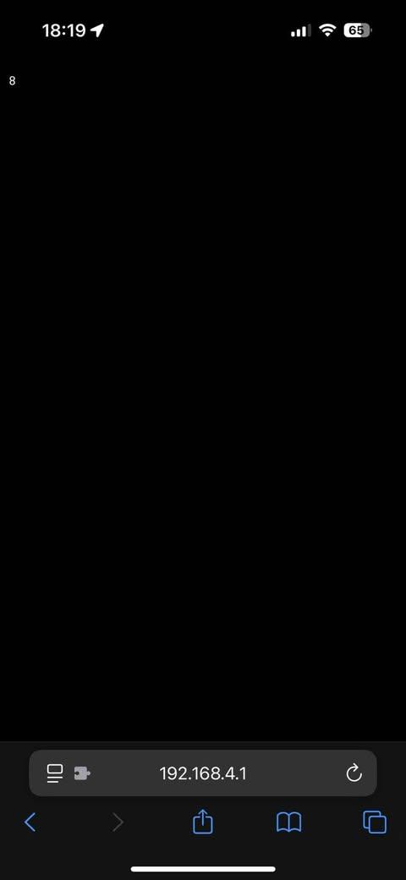
[picture p33: figure]

Rys 33. Przesyłanie danych na serwer http, z widoczną cyfrą 8 – odebraną przez UART.

Na szczęście, istnieje protokół firmy Espressif ESP-NOW, umożliwiający bezpośrednią komunikację mikrokontrolerów ESP32 między sobą, za pomocą adresów MAC.
W tym momencie pojawił się duży problem – przesuwanie się ramki początku transmisji. Po odebraniu danych przez ESP8266 co transmisje bajty przesuwały się względem siebie. Musiał więc zostać uwzględniony mechanizm szukania początku ramki i dopiero wtedy składania podzielonych danych.
Gdy zostało to zrealizowane, pojawił się kolejny problem – naszą ramką była wartość 0xFF. Gdy wychylenie joysticka było maksymalne, dostawaliśmy starszy bajt o wartości właśnie 255. Dane wychodziły błędne. Próbując zmodyfikować ramkę, by była na więcej niż 1 bajcie, dane przestawały być poprawnie odbierane – już zabrakło czasu na debugowanie, więc nie wiemy w którym miejscu był błąd. Protokół ESP-NOW pozwala na jednorazowe wysłanie 200 bajtów, więc zwiększenie nie powinno (w teorii) pogorszyć niczego. Natomiast została wykorzystana wcześniej omówiona nieliniowość joysticka. Są pewne wartości rezystancji, których prawdopodobieństwo wystąpienia jest na tyle niskie, że nie przeszkadza to w poprawnej pracy. Zatem nowa wartość ramki to 0xA0.

## 3.4 Niedziałanie programu przy zewnętrznym zasilaniu

Po przetestowaniu programu i stwierdzeniu jego poprawności, STM32 została zasilona zewnętrznie. Program nie uruchamiał się. Po przejrzeniu forów internetowych wydawało się, że nie zapisuje programu do pamięci flash tylko do ramu. W programie STlink Utility wszystko wyglądało na poprawnie, dane były zapisane do pamięci flash. Jednak program nie działał w dalszym ciągu. Został wygenerowany też blik binarny z programem i był wgrywany z poziomu STlink Utility. Dalej nie działało. Powodem okazał się być włączony semihosting. Wymaga on działającego debuggera, w przeciwnym razie spowoduje to uruchomienie wyjątku, powodującego zatrzymanie pracy MCU. Po jego wyłączeniu program działał bez podpiętego przewodu USB, z pinu E5V.

## 3.5 Zaszumione dane z wifi:

Po odbiorze danych przez ESP i przekazanie ich do STM32(1) zauważyliśmy, że co kilka kilkanaście probek odczyt jest mocno zawyżony. Po z debuggowaniu problemu zdecydowaliśmy się na filtracje wyników za pomocą filtru medianowego.

## 3.6 Silniki nie chciały się kręcić w momencie wychylenia

joysticka.

Gdy udało się wysyłać i odbierać dane to zauwazylismy dziwny problem. Mimo, że wartości obliczonej prędkości silników były prawidłowo przekazywane do rejestrów licznika, generujących PWM (sprawdziliśmy to podglądając wartości na bieżąco w rejestrach oraz printując wyniki na konsole) to okazało się, że silniki albo się nie kręcą, albo nie przestają kręcić, gdy joystick nie jest wychylony. W tym momencie wpadliśmy na pomysł, żeby wysterować linię odpowiedzialną za przekazywanie sygnału PWM do drivera w tryb Pull-down, czyli podciągania do masy. Faktycznie przy braku tej opcji nie wiedzieliśmy co się dzieje na linii w momencie, gdy sygnał PWM przestaje być generowany, a dzięki temu rozwiązaniu zapewniliśmy sobie logiczne 0 na linii. Również inne linie wysterowaliśmy w podobny sposób.

## 3.7 Sygnał PWM nie uruchamiał drugiego silnika

Gdy podłączyliśmy cały układ, na wydrukowanym przez nas samochodzie to zauważyliśmy, że silnik lewy nie chce się kręcić. Wydawało się to dziwne, ponieważ zarówno w programie, jak i podłączając się sondom do pinu na stm32 widzieliśmy generowany sygnał PWM. Multimetrem zbadaliśmy czy nie są uszkodzone kable łączące driver z silnikami. W tym momencie zauważyliśmy, że jeden z polutowanych pinów na driverze nie do końca styka. Gdy go docisnęliśmy to silnik zaczął się kręcić

## 3.8 Zbyt mały moment obrotowy silników

Niestety nasze silniki miały bardzo dużą prędkość obrotową, ale zbyt mały moment obrotowy. Niestety na ten problem nie udało się nic poradzić. W momencie, gdy samochód był trzymany w powietrzu to koła kręciły się prawidłowo. Jednak, gdy kładliśmy go na powierzchni, to siła tarcia statycznego była zbyt duża, a moment obrotowy silników zbyt mały i pojazd nie był w stanie się poruszyć. Rozwiązaniem byłoby wymiana silników na takie z przekładnią pozwalającą zwiększyć moment obrotowy kosztem prędkości obrotowej.

## 3.9 Tragiczny sygnał zasilający

Zasilaniem naszego układu było 6 baterii AAA połączone na 2 koszyczkach zapewniających w sumie 6V napięcia zasilania dla silników i STM32. Jednak napięcie zasilania z baterii było tak bardzo niestabilne, że podglądając wartość na oscyloskopie obserwowaliśmy nawet kilkaset mV tętnień. Powodowało to, że STM32 miała tak niestabilne napięcie, że po prostu się resetowała. Postanowiliśmy więc zasilić STM32 z powerbanka, który miał napięcie dużo stabilniejsze, a sam driver pozostawić na zasilaniu z baterii (nie wymaga on bardzo stabilnego zasilania).

## 4 Druk 3D:

Cały samochód zaprojektowaliśmy w programie Fusion 360 umożliwiający stworzenie plików .stl umożliwiających ich wydrukowanie.

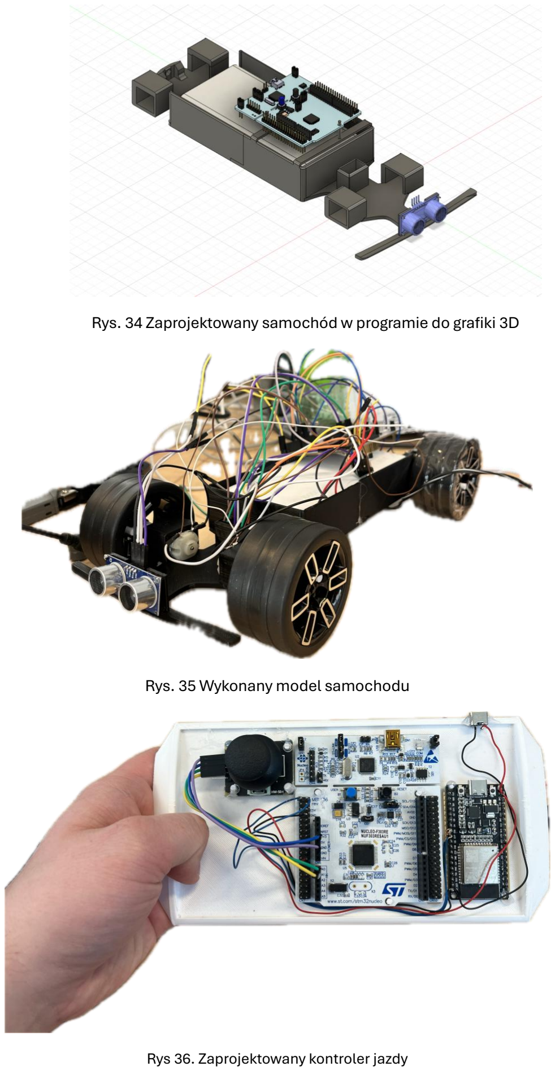
[picture p34: page 29]

Rys. 34 Zaprojektowany samochód w programie do grafiki 3D

Rys. 35 Wykonany model samochodu

Rys 36. Zaprojektowany kontroler jazdy
