mkrawiec261/RemoteCarSTM32/Controller/Core/Inc/main.h

#define B1_Pin GPIO_PIN_13
#define B1_GPIO_Port GPIOC
#define ECHO_Pin GPIO_PIN_0
#define ECHO_GPIO_Port GPIOC
#define LED_Warning_Pin GPIO_PIN_3
#define LED_Warning_GPIO_Port GPIOC
#define LED2_Pin GPIO_PIN_5
#define LED2_GPIO_Port GPIOA
#define TRIG_Pin GPIO_PIN_11
#define TRIG_GPIO_Port GPIOB
#define TRIGC8_Pin GPIO_PIN_8
#define TRIGC8_GPIO_Port GPIOC
#define MODE_Pin GPIO_PIN_8
#define MODE_GPIO_Port GPIOA
#define APHASE_Pin GPIO_PIN_9
#define APHASE_GPIO_Port GPIOA
#define BPHASE_Pin GPIO_PIN_10
#define BPHASE_GPIO_Port GPIOA
