mkrawiec261/RemoteCarSTM32/Controller/Core/Src/hc_sr_04.c

/*
 * hc_sr_04.c
 *
 *  Created on: Jan 5, 2025
 *      Author: root
 */

#include "stm32f3xx_hal.h"
#include "hc_sr_04.h"

#define HC_SR04_US_TO_CM_CONVERTER	58

void hc_sr_04_init(struct us_sensor_str *us_sensor, TIM_HandleTypeDef *htim_echo, TIM_HandleTypeDef *htim_trig, uint32_t trig_channel)
{
    us_sensor->htim_echo = htim_echo;          // Przypisz timer dla echa
    us_sensor->htim_trig = htim_trig;          // Przypisz timer dla triggera
    us_sensor->trig_channel = trig_channel;    // Przypisz kanał triggera

    // Rozpocznij działanie kanałów Input Capture oraz PWM
    HAL_TIM_IC_Start_IT(us_sensor->htim_echo, TIM_CHANNEL_1 | TIM_CHANNEL_2);
    HAL_TIM_PWM_Start(us_sensor->htim_trig, us_sensor->trig_channel);
}


uint32_t hc_sr_04_convert_us_to_cm(uint32_t distance_us)
{
	return (distance_us / HC_SR04_US_TO_CM_CONVERTER);
}
